adamcroft330/adamcroft.github.io/images/control-panel-testing.jpg

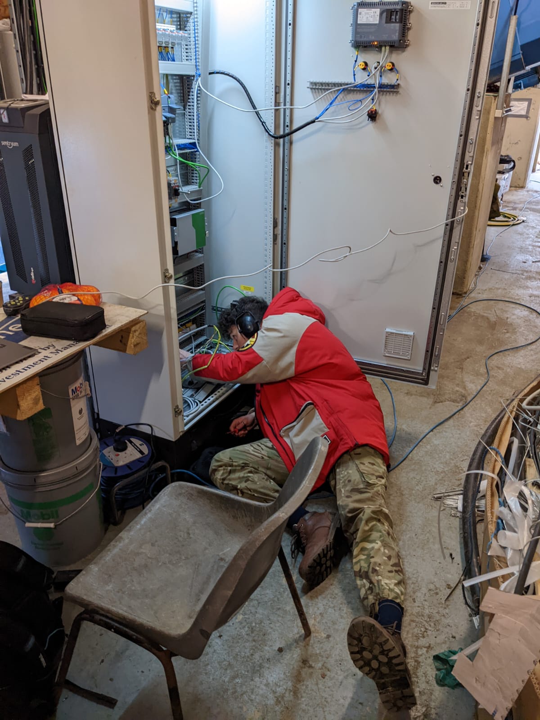
images/control-panel-testing.jpg
