adamcroft330/adamcroft.github.io/images/Settle-hydro-1.JPG

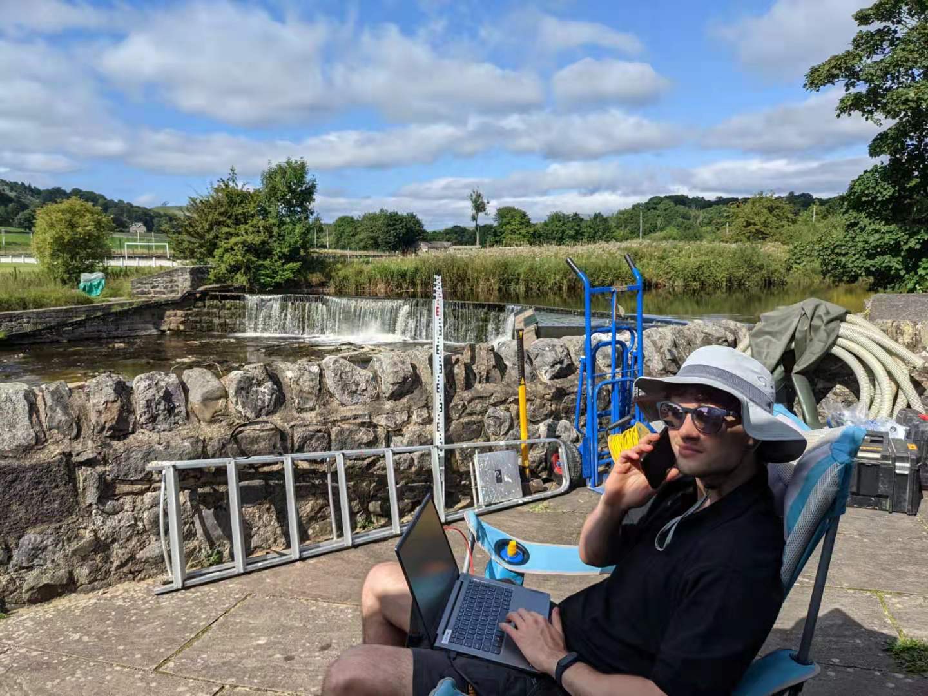
images/Settle-hydro-1.JPG
