adamcroft330/adamcroft.github.io/images/controlling_plane.jpg

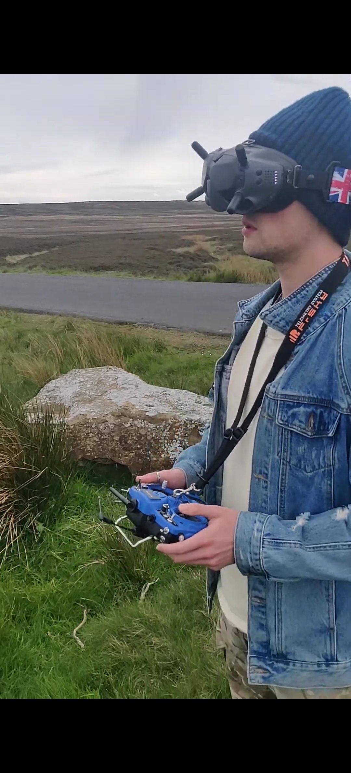
images/controlling_plane.jpg
