adamcroft330/adamcroft.github.io/images/evtol-bank-right.jpg

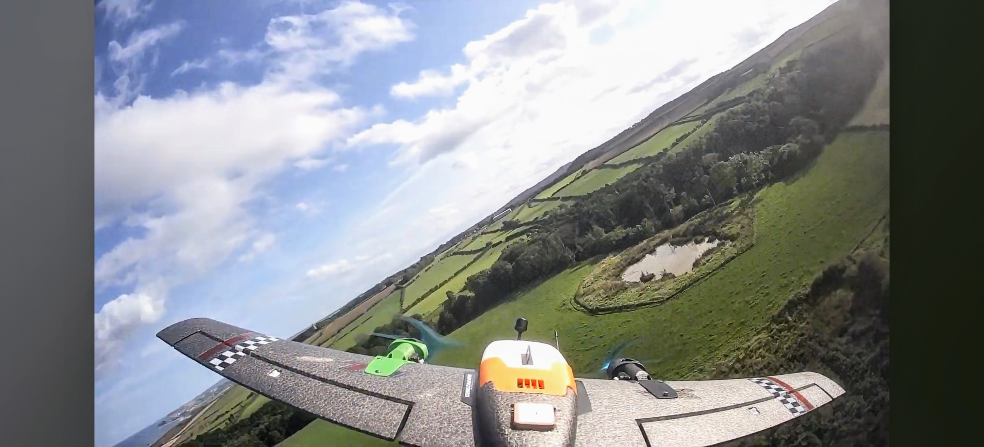
images/evtol-bank-right.jpg
