adamcroft330/adamcroft.github.io/images/evtol-on-wall.jpg

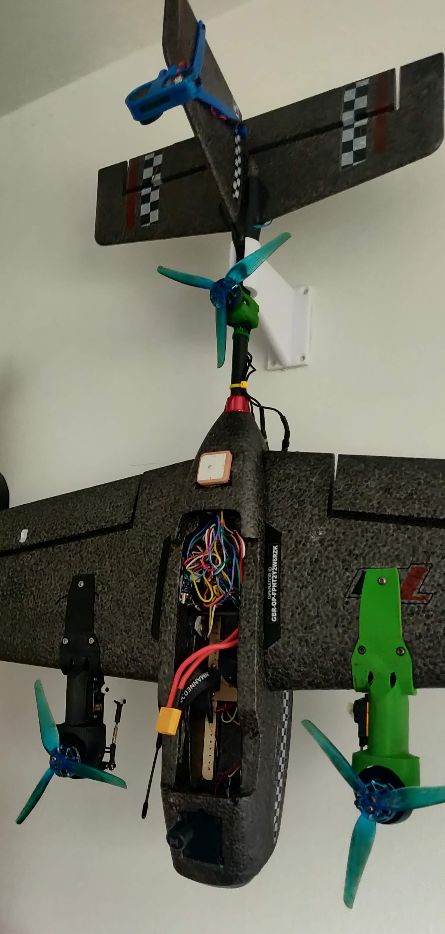
images/evtol-on-wall.jpg
