adamcroft330/adamcroft.github.io/images/nethermills-forebay.jpg

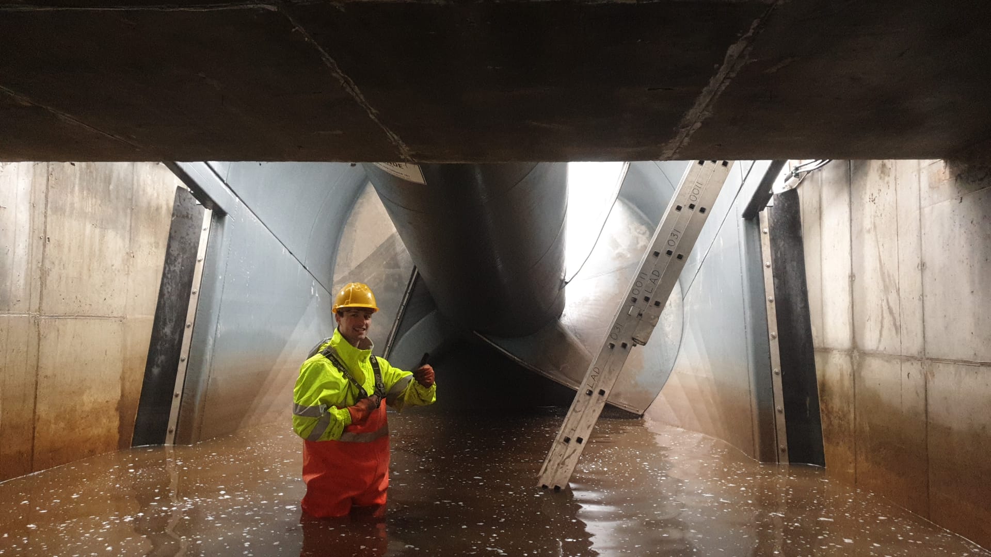
images/nethermills-forebay.jpg
