adamcroft330/adamcroft.github.io/images/p&a-goggles.jpg

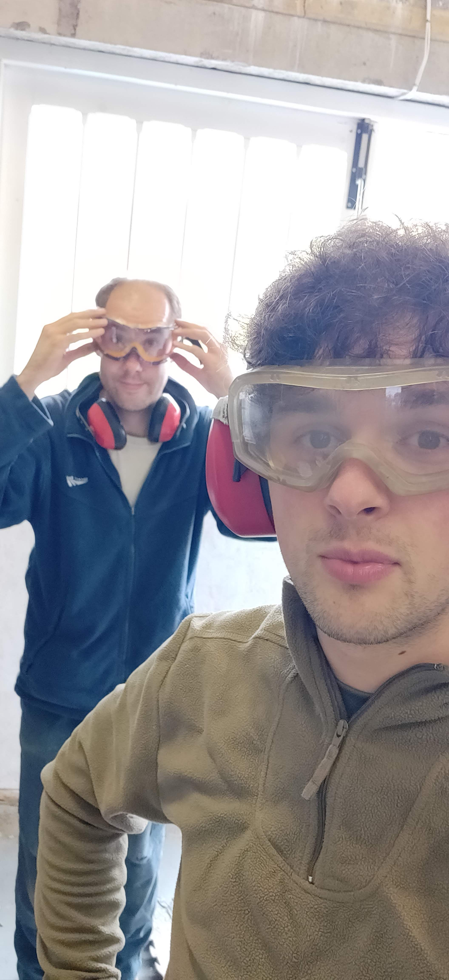
images/p&a-goggles.jpg
