adamcroft330/adamcroft.github.io/images/settle-boys.jpg

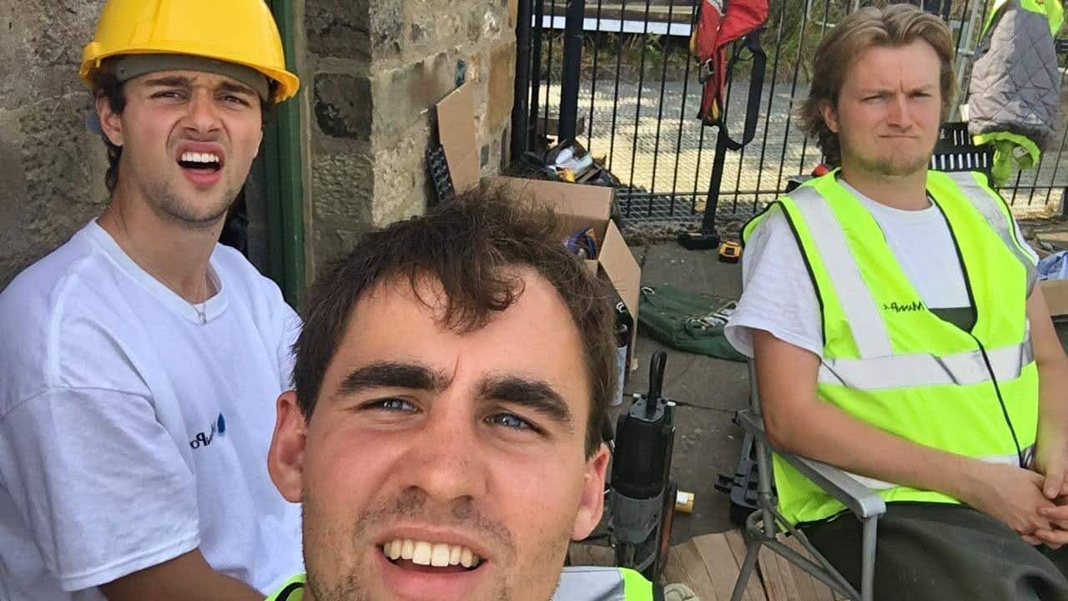
images/settle-boys.jpg
