adamcroft330/adamcroft.github.io/images/whats-that-noise.jpg

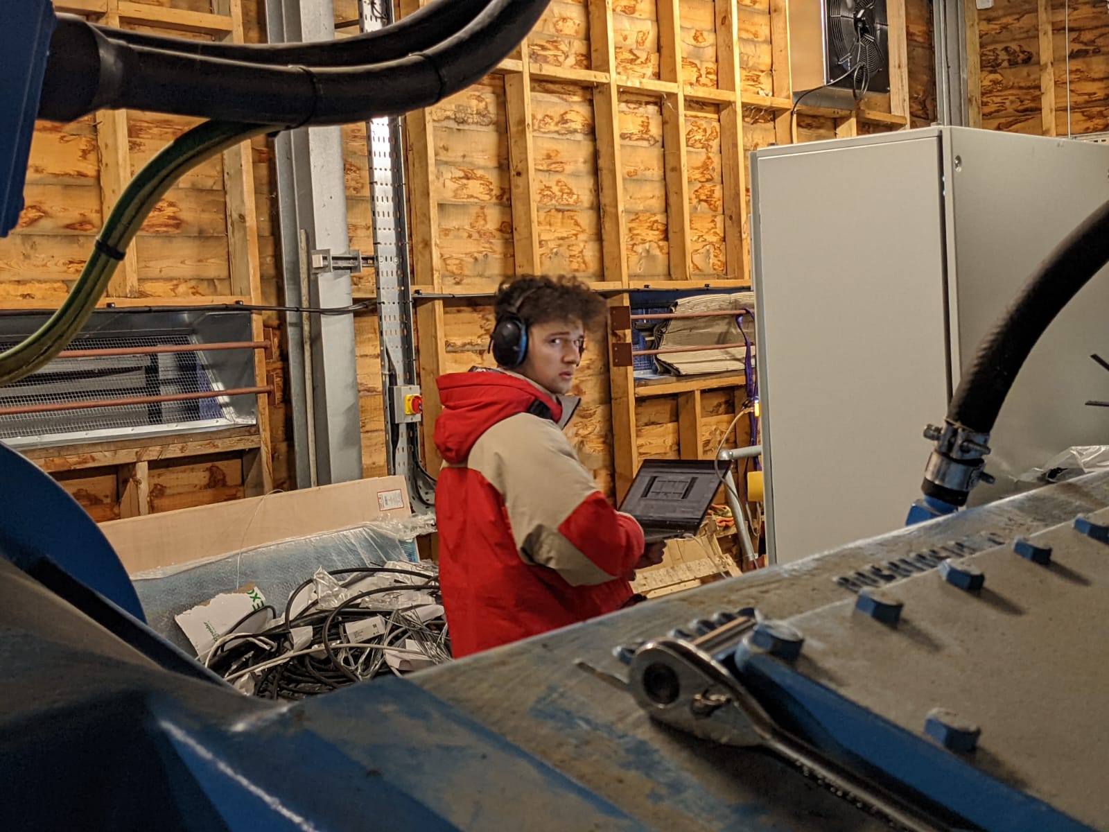
images/whats-that-noise.jpg
