adamcroft330/adamcroft.github.io/themis/cad/themis35-bom.csv

Group | Item | Part | Qty | Unit | Unit mass (g) | Line mass (g) | Mass source | Size | Size source | Material | Link | Notes
Airframe (printed) | Duct | Themis 35 duct, quadrant-trimmed bellmouth | 4 | each | 18.2 | 72.82 | cad | 106.7 × 106.7 × 31 mm | cad | SLS PA12, 1.2 mm wall; 2 dyed orange (front), 2 black | https://3dprint-uk.co.uk/3d-printing-services/ | One STL printed four times; front pair dyed orange
Airframe (printed) | Crest clip | Joins neighbouring ducts over the shared crest | 4 | each | 0.16 | 0.63 | cad | 27 × Ø2.7 mm | cad | SLS PA12 | https://3dprint-uk.co.uk/3d-printing-services/
Airframe (printed) | Spine | Cruciform pylon with harness conduit, ESC bosses and cable windows | 1 | each | 12.97 | 12.97 | cad | 41 × 41 × 42 mm | cad | SLS PA12 | https://3dprint-uk.co.uk/3d-printing-services/
Airframe (printed) | Camera fairing | Belly fairing for the downward camera, lens window | 1 | each | 4.9 | 4.9 | cad | 43 × 43 × 23.5 mm | cad | SLS PA12 | https://3dprint-uk.co.uk/3d-printing-services/
Airframe (printed) | Sensor blister | Fairing under motor 2's pad for the H-Flow | 1 | each | 1.89 | 1.89 | cad | 33 × 33 × 11.5 mm | cad | SLS PA12 | https://3dprint-uk.co.uk/3d-printing-services/
Airframe (printed) | Pod lower | Streamlined pod: floor, ledges, canopy posts, vents, spine slot | 1 | each | 36.8 | 36.8 | cad | 68 × 134 × 46 mm | cad | SLS PA12, 1.6 mm skin | https://3dprint-uk.co.uk/3d-printing-services/
Airframe (printed) | Canopy | Removable top shell with moulded front arrow | 1 | each | 22.54 | 22.54 | cad | 68 × 134 × 34 mm | cad | SLS PA12, 1.6 mm skin | https://3dprint-uk.co.uk/3d-printing-services/
Airframe (printed) | Pi shelf | 54 mm wide, keyed to its ledges | 1 | each | 7.58 | 7.58 | cad | 54 × 88 × 1.6 mm | cad | SLS PA12 | https://3dprint-uk.co.uk/3d-printing-services/
Airframe (printed) | Battery tray | 60 mm wide with front end stop and rear XT60 holder | 1 | each | 10.74 | 10.74 | cad | 60 × 102 × 8.1 mm | cad | SLS PA12 | https://3dprint-uk.co.uk/3d-printing-services/
Airframe (printed) | Nose bumper | Protects the Mightycam window; marks the front | 1 | each | 1.49 | 1.49 | cad | 35 × 4.5 × 39 mm | cad | TPU 95A, orange | https://3dprint-uk.co.uk/3d-printing-services/
Airframe (printed) | UWB hat | Low spine on the canopy roof: carries the UWB board above the battery | 1 | each | 4.51 | 4.51 | cad | 29 × 81 × 6 mm | cad | SLS PA12 | https://3dprint-uk.co.uk/3d-printing-services/ | Two M2.5 screws up through the roof; two cable ties hold the board
Airframe (printed) | Foot | TPU post with captive M2.5 nut; lowest point of the drone | 4 | each | 2.53 | 10.14 | cad | Ø10 × 29.5 mm | cad | TPU 95A, black | https://3dprint-uk.co.uk/3d-printing-services/
Airframe (carbon) | Carbon plate | Centre plate, arms, motor pads, tails; DXF exported | 1 | each | 24.44 | 24.44 | cad | 190 × 190 × 2.5 mm | cad | 3K carbon fibre, 2.5 mm | https://www.pcbway.com/rapid-prototyping/cnc-machining/plastic/carbon-fiber/carbon-fiber-plate/ | Quote also from Carbon Fibre Tubes Ltd (Fareham)
Propulsion | Motor | GEPRC SPEEDX2 2105.5 3450KV (3–4S), 12×12 M2, 1.5 mm shaft | 4 | each | 21.0 | 84.0 | retail | Ø25.65 × 15.7 mm; leads 22 AWG × 150 mm | retail | — | https://uk.banggood.com/en/GEPRC-SPEEDX2-2105_5-2650KV-or-3450KV-3-4S-Brushless-Motor-for-FPV-Racing-RC-Drone-p-1949985.html | Mass includes leads. Supplied with M2×6 and M2×7 screws. Use 3450KV: the 2150/2650KV versions are 6S motors
Propulsion | Propeller | Gemfan D90S 3-blade, 90 mm, 3" pitch, 1.5 mm T-mount | 4 | each | 2.3 | 9.2 | retail | Ø90 × 5.5 mm hub | retail | Polycarbonate | https://www.getfpv.com/gemfan-d90s-90mm-3-5-ducted-3-blade-cinewhoop-propeller-1-5mm-shaft-set-of-4.html | 2 CW + 2 CCW. Hub diameter modelled at 9 mm (not published)
Propulsion | 4-in-1 ESC | SpeedyBee BLS 35A Mini V2, 20×20, 3–6S, 35 A ×4 (45 A 5 s) | 1 | each | 7.2 | 7.2 | retail | 35 × 35 × 5.5 mm | retail | — | https://nextfpv.com/products/speedybee-bls-35a-mini-v2-20x20-4-in-1-esc | BLHeli_S, DShot300/600; current sensor scale 250, offset −500. Mounted rotated 45° between the ducts
Propulsion | ESC capacitor | 100 µF 35 V low-ESR electrolytic (Panasonic FR series), 4 fitted = 400 µF | 4 | each | 0.6 | 2.4 | est | Ø6.3 × 11.2 mm (est.) | est | — | https://uk.rs-online.com/web/c/?searchTerm=panasonic%20EEU-FR1V101 | A single Ø10 mm 470 µF (EEU-FR1V471, RS 708-3825) does not fit between the ducts; four small ones sit on the axes just outside the ESC
Power | Battery | GNB GNB11004S140A, 4S 1100 mAh 140C, XT60 | 1 | each | 141.0 | 141.0 | maker | 82 × 39 × 25 mm | maker | LiPo | https://www.gaoneng.shop/products/gaoneng-gnb-4s-14.8v-1100mah-140c-xt60-lipo-battery | Figures as cited in the AVA v2 README; the shop blocks automated reading, so check the listing
Power | Power module | Holybro PM02 V3, analog, 5.2 V 3 A to the Pixhawk | 1 | each | 20.0 | 20.0 | maker | 25 × 25 × 10 mm | retail | — | https://docs.px4.io/main/en/power_module/holybro_pm02 | Size from an OpenELab listing; Holybro does not publish it. XT60s removed, leads soldered. Its XT60/12 AWG are rated 30 A continuous, 60 A burst: cap PX4 thrust so total current stays under 60 A
Power | 5 V regulator | Pololu D36V50F5, 5 V 5.5 A, 5.5–50 V in | 1 | each | 7.0 | 7.0 | maker | 25.4 × 25.4 × 9.5 mm | maker | — | https://www.pololu.com/product/4091/specs | Feeds the Pi 5 through GPIO 5 V; set usb_max_current_enable=1
Power | XT60H-F | Amass XT60H female with housing | 2 | each | 3.6 | 7.2 | retail | 21.0 × 15.7 × 8.1 mm | retail | Nylon / brass | https://ifuturetech.org/product/amass-xt60h-female-connector-with-housing/ | Main socket (behind the battery) and arming socket (tail). Datasheet: cdn.eicom.ru/media/PDF/XT60H-M.pdf
Power | XT60H-M arming key | Amass XT60H male, pins bridged with 14 AWG, red pull tab | 1 | each | 4.5 | 4.5 | est | 21 × 15.7 × 8.1 mm + loop | retail | Nylon / brass / silicone | https://cdn.eicom.ru/media/PDF/XT60H-M.pdf | Pull it and the battery is disconnected: the accessible physical kill
Power | Battery strap | T-Hobby 15 × 200 mm battery strap | 1 | each | 2.5 | 2.5 | est | 15 × 200 mm | retail | Woven nylon | https://www.unmannedtechshop.co.uk/products/t-hobby-battery-straps-15x200mm-new
Flight control | Flight controller | Holybro Pixhawk 6C Mini (Model A), PX4 | 1 | each | 39.2 | 39.2 | maker | 54.3 × 39 × 17.5 mm | maker | Aluminium case | https://docs.holybro.com/autopilot/pixhawk-6c-mini/dimensions | Mass from PX4 docs. Motors on the FMU outputs (DShot). Cable set supplied: 6-pin GH ×5, 4-pin GH ×3, PWM ×2
Flight control | Mounting foam | 3M 4026 urethane foam tape, 1.6 mm (4 pads) | 1 | each | 0.5 | 0.5 | est | 1.6 mm thick | maker | Urethane foam | https://hoffmann-group.com/GB/en/houk/p/7000116032- | Under the Pixhawk, PM02 and BEC
Flight control | ELRS receiver | RadioMaster RP1 V2, 65 mm UFL T-antenna | 1 | each | 2.2 | 2.2 | retail | 13 × 11 × 3 mm | retail | — | https://www.getfpv.com/radiomaster-rp1-v2-expresslrs-2-4ghz-nano-receiver-w-65mm-ufl-t-antenna.html | CRSF to Pixhawk TELEM1; kill switch only. Mass includes antenna
Companion compute | Raspberry Pi 5 | Raspberry Pi 5, 2 GB | 1 | each | 46.0 | 46.0 | retail | 85 × 56 mm PCB; M2.5 holes on 58 × 49 | maker | — | https://datasheets.raspberrypi.com/rpi5/raspberry-pi-5-mechanical-drawing.pdf | Mass from retailer listings (45–46 g). Port heights from the Pi 4 equivalents
Companion compute | Active Cooler | Raspberry Pi Active Cooler for Pi 5 | 1 | each | 29.0 | 29.0 | retail | 63.5 × 42.5 × 13.7 mm | maker | Anodised aluminium | https://datasheets.raspberrypi.com/cooling/raspberry-pi-active-cooler-product-brief.pdf
Companion compute | microSD | High-endurance microSD, 32 GB | 1 | each | 0.4 | 0.4 | est | 15 × 11 × 1 mm | maker | — | https://uk.rs-online.com/web/c/?searchTerm=sandisk%20high%20endurance%20microsd%2032gb | Read-only root filesystem: the arming plug cuts power instantly
Sensors | Downward camera | Arducam B0445, IMX296 colour global shutter, M12 mount | 1 | each | 14.0 | 14.0 | est | 38 × 38 mm board; 13 mm holder | retail | — | https://www.arducam.com/1-58mp-imx296-color-global-shutter-camera-module-with-m12-lens-for-raspberry-pi.html | 14 g is the mono twin's listed weight with its stock lens. Hole pattern to confirm on delivery
Sensors | Camera fixings | M2 × 8 nylon screw + 2 mm nylon spacer, ×4 (hole pattern to confirm) | 4 | each | 0.15 | 0.6 | est | Ø4 × 2 mm spacer | est | Nylon | https://uk.rs-online.com/web/c/?searchTerm=M2%20nylon%20spacer%202mm
Sensors | Wide lens | Arducam M27210H08 (LN005), 2.1 mm M12, 120° HFOV on 1/2.9" | 1 | each | 5.0 | 5.0 | est | Ø14 × 16 mm (est.) | est | — | https://www.arducam.com/blog/product/m27210h08-2/ | Buy one first and check focus in the B0445 holder
Sensors | Camera ribbon | 22-pin 0.5 mm FPC, 200 mm (supplied 22-22 with the B0445; check length) | 1 | each | 1.0 | 1.0 | est | 200 × 13 × 0.3 mm (est.) | est | Polyimide | https://www.arducam.com/1-58mp-imx296-color-global-shutter-camera-module-with-m12-lens-for-raspberry-pi.html
Sensors | Optical flow + range | Holybro H-Flow (bare PCB), PAA3905 + AFBR-S50 + IMU, DroneCAN | 1 | each | 3.5 | 3.5 | retail | 26 × 26 mm PCB; 20×20 M2 holes | maker | — | https://docs.holybro.com/peripherals/h-flow-dronecan/dimensions | Component height modelled at 4 mm (from the case drawing). CAN cable supplied
Sensors | Forward camera | Mighty Camera V.1: 160°, VIO 60 Hz, USB 2.0 | 1 | each | 10.0 | 10.0 | maker | 33 × 30 mm PCB | maker | — | https://mightycamera.com | Lens size modelled at Ø12 × 9 mm (not published)
Comms | UWB board | Makerfabs ESP32 UWB DW3000: ESP32 + Qorvo DW3000, USB to the Pi | 1 | each | 12.0 | 12.0 | est | 72.0 × 32.6 mm board (Makerfabs board file); 6.3 mm deep | maker | FR4 | https://www.tindie.com/products/makingfab/esp32-uwb-dw3000/ | Rides on the canopy hat, above every drone's body; no carrier PCB to design. Check the DW3000 antenna's orientation on the bench
Comms | Mightycam USB lead | USB 2.0 lead, right-angle USB-A, about 150 mm | 1 | each | 6.0 | 6.0 | est | Ø3.2 mm cable | est | — | https://uk.rs-online.com/web/c/?searchTerm=right%20angle%20usb%20a%20cable%20150mm | Mightycam-side connector to confirm
Comms | UWB USB lead | Micro-USB to right-angle USB-A, about 250 mm, down through the canopy roof | 1 | each | 7.0 | 7.0 | est | Ø3.2 mm cable | est | — | https://uk.rs-online.com/web/c/?searchTerm=right%20angle%20usb%20a%20to%20micro%20usb%20cable | Unplug at the board to lift the canopy off
Wiring | 14 AWG silicone wire | Red + black, battery to PM02 to ESC | 0.447 | m | 28.2 | 12.61 | retail | Ø3.5 mm; 28.2 g/m per core | retail | Copper / silicone | https://shop.pimoroni.com/en-eu/products/dual-silicone-wire-per-metre
Wiring | 20 AWG silicone wire | Red + black, PM02 to BEC to Pi | 0.212 | m | 7.1 | 1.51 | retail | Ø1.8 mm; 7.1 g/m per core | retail | Copper / silicone | https://shop.pimoroni.com/en-eu/products/dual-silicone-wire-per-metre
Wiring | JST-GH signal leads | TELEM1, TELEM2, POWER, CAN1 (from the Pixhawk/PM02/H-Flow sets, re-pinned) | 0.594 | m | 15.0 | 8.91 | est | Ø2.0–2.6 mm bundles; 15 g/m est. | est | Copper / PVC | https://www.worldronemarket.com/product/holybro-pixhawk-6c-mini-cable-set/
Wiring | ESC signal lead | JST-SH 8-pin to Pixhawk PWM header (supplied with ESC) | 0.072 | m | 15.0 | 1.08 | est | Ø2.8 mm bundle; 15 g/m est. | est | Copper / PVC | https://nextfpv.com/products/speedybee-bls-35a-mini-v2-20x20-4-in-1-esc
Wiring | Heat-shrink and cable ties | Assorted, 1.5–6 mm | 1 | each | 2.0 | 2.0 | est | — | — | Polyolefin / nylon | https://uk.rs-online.com/web/c/?searchTerm=heat%20shrink%20assortment
Fasteners & inserts | M2 × 6 cap screw | Motor mount (supplied with the motors) | 16 | each | 0.33 | 5.25 | cad | M2 × 6, head Ø3.8 × 2 | maker | Steel | https://uk.banggood.com/en/GEPRC-SPEEDX2-2105_5-2650KV-or-3450KV-3-4S-Brushless-Motor-for-FPV-Racing-RC-Drone-p-1949985.html
Fasteners & inserts | M3 × 16 button head | ESC stack: plate, grommets, ESC, spine inserts (ISO 7380 A2) | 4 | each | 1.23 | 4.9 | cad | M3 × 16, head Ø5.7 × 1.65 | maker | A2 stainless | https://accu-components.com/us/button-head-screws
Fasteners & inserts | M2.5 × 12 cap screw | Duct boss, plate, foot nut (DIN 912 A2) | 4 | each | 0.78 | 3.12 | cad | M2.5 × 12, head Ø4.5 × 2.5 | maker | A2 stainless | https://accu-components.com/us/metric-cap-head-screws/3807-SSCF-M2-5-12-A2
Fasteners & inserts | M2.5 nut | Captive in each foot (DIN 934 A2) | 4 | each | 0.34 | 1.37 | cad | 5 AF × 2 mm | maker | A2 stainless | https://accu-components.com/us/hexagon-nuts
Fasteners & inserts | M2.5 × 6 button head | Pod floor to spine cap, under the Pixhawk foam (ISO 7380 A2) | 4 | each | 0.42 | 1.7 | cad | M2.5 × 6, head Ø4.7 × 1.4 | maker | A2 stainless | https://accu-components.com/us/button-head-screws
Fasteners & inserts | M2.5 × 6 cap screw | Pi shelf and battery tray to their ledges; UWB hat through the canopy roof (DIN 912 A2) | 6 | each | 0.55 | 3.28 | cad | M2.5 × 6, head Ø4.5 × 2.5 | maker | A2 stainless | https://accu-components.com/us/metric-cap-head-screws
Fasteners & inserts | M2 × 10 cap screw | H-Flow through motor 2's pad (DIN 912 A2) | 4 | each | 0.43 | 1.71 | cad | M2 × 10, head Ø3.8 × 2 | maker | A2 stainless | https://accu-components.com/us/metric-cap-head-screws
Fasteners & inserts | M2 nut | Under the H-Flow (DIN 934 A2) | 4 | each | 0.18 | 0.7 | cad | 4 AF × 1.6 mm | maker | A2 stainless | https://accu-components.com/us/hexagon-nuts
Fasteners & inserts | M2 × 4 spacer | Holds the H-Flow below the motor screw heads (nylon) | 4 | each | 0.04 | 0.17 | cad | Ø4 × 4 mm | est | Nylon | https://uk.rs-online.com/web/c/?searchTerm=M2%20nylon%20spacer%204mm
Fasteners & inserts | M2.5 × 3 standoff | Pi 5 to shelf, F-F (nylon) | 4 | each | 0.07 | 0.3 | cad | 5 AF × 3 mm | est | Nylon | https://uk.rs-online.com/web/c/?searchTerm=M2.5%20female%20female%20standoff%203mm
Fasteners & inserts | M2.5 × 6 nylon screw | Pi 5 to standoffs, standoffs to shelf | 8 | each | 0.08 | 0.63 | cad | M2.5 × 6, head Ø4.5 × 2.5 | est | Nylon | https://uk.rs-online.com/web/c/?searchTerm=M2.5%20nylon%20screw%206mm
Fasteners & inserts | M3 thumb screw | Canopy, into the four posts (nylon, knurled) | 4 | each | 0.29 | 1.17 | cad | M3 × 8, head Ø8 × 4 | est | Nylon | https://uk.rs-online.com/web/c/?searchTerm=M3%20nylon%20thumb%20screw
Fasteners & inserts | M3 heat-set insert | CNC Kitchen M3 standard: spine ESC bosses, canopy posts | 8 | each | 0.4 | 3.2 | est | 4.6 × 5.7 mm; 4.0 mm hole | retail | Brass | https://www.3djake.com/cnc-kitchen/threaded-inserts-m3-standard
Fasteners & inserts | M2.5 heat-set insert | CNC Kitchen M2.5: spine cap, shelf and tray ledges, UWB hat | 10 | each | 0.3 | 3.0 | est | 4.6 × 4.0 mm; 4.0 mm hole | retail | Brass | https://www.3djake.com/cnc-kitchen/threaded-inserts-m25-standard
Fasteners & inserts | M3 aluminium spacer | Hard-mounts the ESC stack: 1 mm under the ESC, 4.4 mm over it (4 mm spacer + 0.4 mm shim) | 8 | each | 0.15 | 1.18 | cad | Ø6 × 1 mm and Ø6 × 4.4 mm, M3 clearance | est | Aluminium | https://accu-components.com/us/spacers/aluminium-spacers | Replaces the ESC's silicone grommets: on those the pod and battery would rock at an estimated 10–20 Hz
Finishing | Decal set | Motor numbers, rotation arrows (PX4 Quad X), FRONT arrow | 1 | each | 0.3 | 0.3 | est | — | — | Vinyl | CAD/themis35/build_t35.py | Artwork follows the rotation marks in the CAD
 | All up, every line |  |  |  |  | 730.9
