adamcroft330/adamcroft.github.io/themis/track/models/course_1337_tape.stl

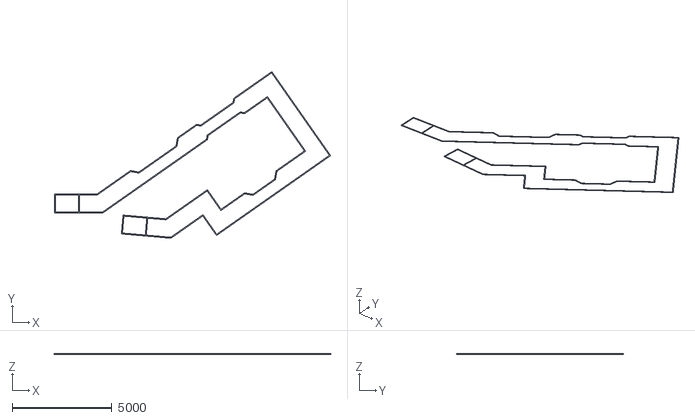
[picture p10: CAD file, 2026-09-12]
themis/track/models/course_1337_tape.stl
13854.9 x 8357.4 x 2.00
