adamcroft330/adamcroft.github.io/themis/track/models/course_1337_hurdles.stl

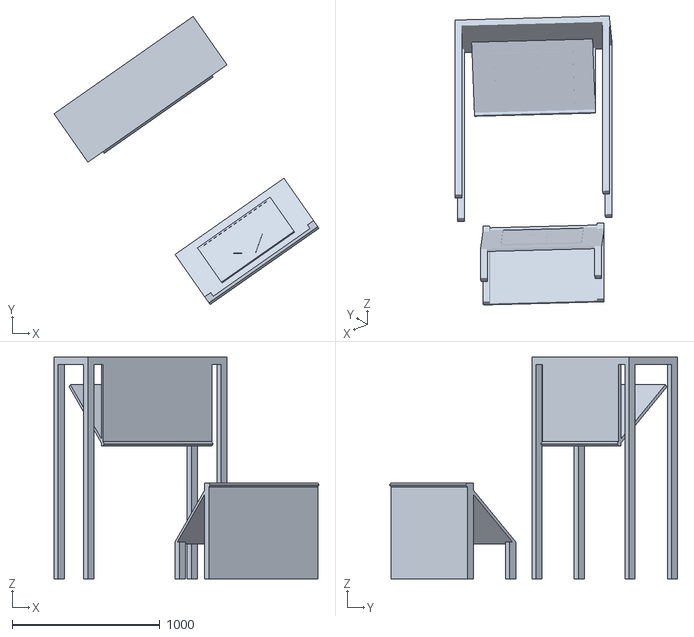
[picture p11: CAD file, 2026-09-12]
themis/track/models/course_1337_hurdles.stl
1794.1 x 1951.1 x 1500.0
