adamcroft330/adamcroft.github.io/themis/track/models/course_1337.stl

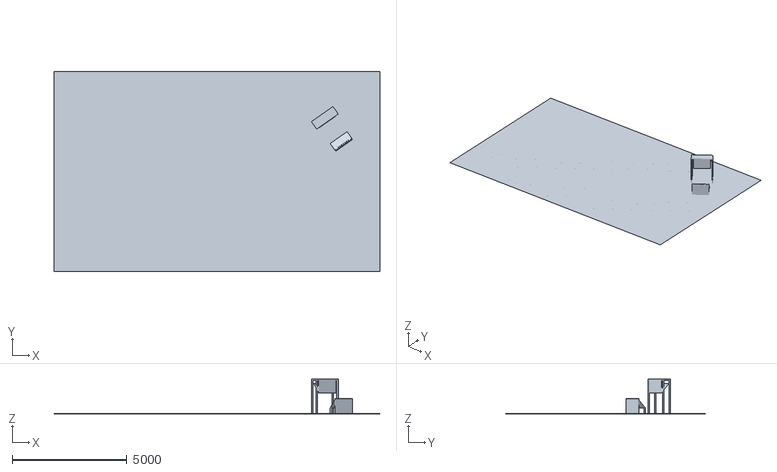
[picture p12: CAD file, 2026-09-12]
themis/track/models/course_1337.stl
14204.9 x 8707.4 x 1510.0
