adamcroft330/adamcroft.github.io/(commit log)

2024-11-16 Added photos page with 1 photo. Updated index and evtol pages with navigation button to photos page.
2025-03-16 added robotic-arm page”
2026-08-07 Update swarm sim: fix FPV track tiles vanishing while panning
2026-08-10 Add decision feed, why-line and velocity term arrows
2026-08-10 Velocity arrows: default off with per-term toggles
2026-08-10 10m ground history + centroid velocity arrow
2026-08-10 Centroid velocity shows detour lateral component
2026-08-10 Add 味 menu site at /menu
2026-08-10 Auto-classify dishes on upload; remove AI Classify button
2026-08-11 Mobile cuisine filter (select), hide empty cuisines, clear stale cache
2026-08-12 Themis drone build: interactive 3D viewer with STL models + part breakdown
    [assembly.stl, battery.stl, cm5.stl, esc.stl, fitment_check.stl, frame.stl, guard.stl, hailo.stl]
2026-08-12 Rename drone-build → themis
    [assembly.stl, battery.stl, cm5.stl, esc.stl, fitment_check.stl, frame.stl, guard.stl, hailo.stl]
2026-08-12 Fix 3D viewer: use script tag instead of importmap, add inline STL loader
2026-08-12 v3 drone model: realistic frame, shaped arms, detailed components
    [assembly_v3.stl, battery_v3.stl, cam_v3.stl, cm5_v3.stl, esc_v3.stl, frame_v3.stl, guard_v3.stl, hailo_v3.stl]
2026-08-12 Fix: all 4 motors/props at correct positions, update viewer center, clean up models
    [assembly_v3.stl, battery.stl, battery_v3.stl, cam.stl, cam_v3.stl, cm5.stl, cm5_v3.stl, esc.stl]
2026-08-13 Custom 3D-printed frame plate: 195mm true-X, 120x70mm center body, 16mm motor mounts, 1806 motors, TWR 3.25:1
    [assembly.stl, battery.stl, cam.stl, cm5.stl, esc.stl, frame.stl, guard.stl, hailo.stl]
2026-08-13 Fix: remove geometry centering that was collapsing Z positions — props now clear frame, hardware sits on plate
2026-08-13 Brighter lighting (4x dir light, 2x ambient), add 50mm scale ruler along X axis
2026-08-13 Screen-anchored scale ruler: projects 250mm bbox to screen px, ticks every 12.5mm, labels every 50mm
2026-08-13 Fix 250mm fit: remove prop guard mounting stubs (was 133.5mm, now 124mm), ring centered on prop disc, envelope 248mm PASSES
    [assembly.stl, guard.stl, motor.stl, plate.stl, prop.stl]
2026-08-13 Switch to orthographic camera: uniform scale on screen, ruler exact from every angle, add resize handling
2026-08-13 Restore perspective camera with static CSS scale ruler — ortho had unreproducible rendering bug in headless Chrome
2026-08-13 Replace static CSS ruler with 3D in-scene ruler at bounding box front face — scales correctly with zoom and perspective
2026-09-08 Add SparkLab learning-lab prototype at /lab
2026-09-10 Pi 5 build v4: real official Pi 5 model (STEP-converted), proper Z-stacking (ESC flat, FC on standoffs, Pi5 beside), downward ToF under plate, Y-up scene fix, updated BOM ()
    [assembly.stl, cam.stl, cm5.stl, esc.stl, guard.stl, motor.stl, pi5.stl, pi5_real.stl]
2026-09-12 Themis hub page: landing at /themis/ linking to racing sim (/swarm/), CAD viewer (/themis/cad/), and track model (/themis/track/); fix root card link from stale /drone-build/
    [assembly.stl, cam.stl, esc.stl, guard.stl, motor.stl, pi5.stl, pi5_real.stl, pixhawk.stl]
2026-09-12 Themis track page: real competition course per brief addendum + seeded 3D course generator
    Replaces the placeholder 1:10 sim-derived spec with the addendum spec (900 mm
    tape corridor, bends, 90° turns, 900→600 mm narrowings, overhead hurdle),
    an in-browser Three.js viewer that regenerates courses by seed, and the
    OpenSCAD-rendered STLs for seed 1337.
    Claude-Session: https://claude.ai/code/session_013weHv1XZhrGrUYx5aVWETm
    [course_1337.stl, course_1337_hurdles.stl, course_1337_tape.stl]
2026-09-12 Line Follower starts with an empty program — kids build it from scratch
2026-09-14 Themis CAD: Integrated housing on Dingcad frame — replace quad viewer with 106-part colored model, explode + internals controls
2026-09-14 Themis RL Eval: live PufferLib training env in the browser (raylib/WebAssembly) at /themis/RL_eval/
    Four drones on random addendum courses with the classical tape-frame planner
    and the bounded RL residual, PX4-style cascade and rotor physics, rendered
    with raylib compiled by Emscripten. Untrained build = classical baseline; a
    trained checkpoint is packed by training/web/publish.sh. Hub card added.
    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
2026-09-14 Themis CAD: slim housing to 92mm, remove Pi5 USB-A/Ethernet bank — drop obsolete quad STLs
    [assembly.stl, cam.stl, esc.stl, guard.stl, motor.stl, pi5.stl, pi5_real.stl, pixhawk.stl]
2026-09-14 RL Eval: rebuild with the formation manager (named slots, resizable box, single-file deviation)
    Baseline over 48 episodes: score -29.3 -> -20.5, tape contacts 14.3 -> 8.7,
    hurdle 0.5 -> 0.1, formation error 0.34 -> 0.21 m, still 100% finish.
    HUD now names the formation shape and the selected drone's slot.
    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
2026-09-14 RL Eval: rebuild with the margin-balanced box and in-box formation grading
    Baseline over 48 episodes: score -20.5 -> -19.4, tape contacts 8.7 -> 8.3,
    formation error 0.214 -> 0.190 m, lap 28.3 -> 25.7 s, still 100% finish.
    Box spacing is now 383 mm, the width that balances tape margin against
    drone-to-drone gap in a 900 mm corridor.
    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
2026-09-14 RL Eval: fix tape drawn across the track at corners; show centroid and slot offsets
    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
2026-09-15 themis/RL_eval: publish the v9 residual policy
    First policy to beat the classical baseline on held-out courses:
    score -15.58 vs -20.12, finish rate 1.00, race time 27.2 s.
    Rebuilt the wasm as well as the weights: the env now bounds the residual with
    tanh rather than clamping it, and v9 was trained under that bound, so the
    previous bundle would have run the policy through the wrong nonlinearity.
    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
2026-09-15 themis/RL_eval: publish v10, trained on the dynamic-slot baseline
    Held-out score -14.25 (v9 was -15.58, classical baseline -20.12), finish 1.00.
    The swarm now lets slot labels rotate with the tape frame through a turn instead
    of making each drone orbit the centroid to keep its label, which is worth 2.5
    points on its own and reduces worst reform time from 3.84 s toward the 2 s rule.
    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
2026-09-15 themis/RL_eval: publish v11, formation now pivots at corners
    Held-out score -13.45 (v10 -14.25, classical baseline -20.12), finish 1.00.
    The slot relabel is now anticipatory: slot offsets are rotated by the heading
    change ahead before asking who is closest, so at a 90 deg right turn the two
    right-hand drones become the two front drones instead of every drone orbiting
    the centroid to keep its label. Corner slot error drops to -0.041 / -0.007 m
    from -0.127 / +0.128.
    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
2026-09-15 themis/RL_eval: rebuild on the current env (policy unchanged, v12)
    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
2026-09-19 Themis CAD: publish aligned AVA v2 frame comparison
2026-09-20 Refine AVA comparison geometry and remove camera drag lag
2026-09-24 Correct v2 payload frame supports and fastener stack
2026-09-27 Add TerraHawk v1 crash summary page at /terrahawk_crash
    One-page occurrence summary of the 27 Sep 2026 QuickTune hover crash:
    the sequence of events, why the tune-induced oscillation caused the
    motor-mount failure (not the reverse), contributing factors, open
    questions and actions before the next flight. It includes the
    "which came first" chart and links to the full report at a fixed
    adSwarm commit.
    Claude-Session: https://claude.ai/code/session_01TvNkatcBVSaqPkaLqg5MZF
2026-10-28 themis/cad: publish Themis 35 r2, keep the AVA comparison as history
    The CAD page now shows the Themis 35 build: the 3D bench with an exploded
    view and a centre-of-mass marker beside the full 58-line BOM, the geometry
    checks, the BOM as CSV and a zip of the STEP, print STLs and plate DXF.
    The original/AVA v2 comparison moves to history.html, linked from the new
    page; the build guide, the Themis index card, the track page and the 404
    now point at the right place.
2026-10-28 themis/cad: add the CineLog35 V2 build beside Themis 35 r3
    The CAD page now carries two frames for the same stack, with a switch,
    each frame's own model, BOM, checks, limits and downloads, and a
    side-by-side comparison.
    Custom frame r3: the ESC stack is hard-mounted on aluminium spacers
    (on silicone grommets the pod and battery would rock at an estimated
    10-20 Hz), and the UWB moves to a Makerfabs ESP32 UWB DW3000 board on a
    low hat on the canopy roof, clear of every body; motor 1 loses its
    blister.
    CineLog35 V2 draft: GEPRC's frame modelled from its published figures
    and photos, with the stock inverted motors, a short pylon that keeps
    the pod 22 mm above the guard, an H-Flow bridge across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
2026-10-28 themis/track: sync course_gen.js comments with the themis repo
    The generator moved from CAD/track to course/ in the themis repo. Only
    comments and toScad's default include path change; this page never calls
    toScad, so the courses it generates are unchanged.
    Claude-Session: https://claude.ai/code/session_01JBhNSSbWJuEgwtzLbCs1v7
2026-10-29 themis/RL_eval: new env (Themis 35 sizes and airframe), classical baseline
    For review: the env now models the drones at their CAD size (213 mm across,
    730 g, 142 mm wheelbase) instead of 250 mm cubes at 430 g, and the page flies
    the classical planner with no RL residual. Policy v12 was trained on the old
    env, so it is not packed. Built from themis 7b655b5 plus uncommitted env
    changes; the renderer and legend show the new drone size.
    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
2026-10-29 themis/RL_eval: lanes + UWB chain controller on T, sharper canvas
    Press T to switch between the September controller (centroid and slots) and
    the proposed one: no centroid, each drone holds its lane from the tape and its
    spacing by one UWB range in a chain behind the front-right drone, which sets
    the speed; a compact box slides through 90-degree turns. The new controller's
    view draws the leader, what it reads ahead, the chain links coloured by
    spacing error and where each follower is aiming. The canvas now matches the
    screen's real pixels, so the full-screen view is sharp on high-density screens.
    Claude-Session: https://claude.ai/code/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
2026-10-29 themis/RL_eval: the T controller now holds slots to the leader
    The alternative controller on T no longer runs a chain of followers, which was
    too slow for a feature every ~2 m. Each drone holds its lane from the tape and
    its slot relative to the front-right drone, which sets the speed and
    broadcasts it with its progress; shape changes run on the leader's schedule,
    and a compact box slides through 90-degree turns. Progress is estimated by
    odometry realigned at every feature and trimmed by UWB ranges. The view draws
    a link from each follower to the leader and the slot it is aiming for.
    Claude-Session: https://claude.ai/code/session_01JBh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
2026-10-29 themis/RL_eval: drones with their payload; like-for-like controllers
    The drones are drawn from the CAD with their ducts, pod, canopy and UWB hat
    instead of a flat frame. Both controllers now run on realistic sensing
    (odometry with feature fixes, UWB ranges), so the T switch compares like with
    like, and the 90-degree slide is off until it pays. Tape contacts count only
    once more than half a drone is over the line.
    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
2026-10-29 themis/RL_eval: camera model and no map
    Both controllers now also fly on a downward camera's lateral reports and see
    only 1.5 m past the front drone, as they would without a map.
    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
2026-10-30 themis/RL_eval: leader controller fixes, slower bends (themis bd6fa34)
    Classical baseline, no policy. Both controllers fly with a per-drone speed cap and
    slower bends (v_bend45 0.9, v_turn90 0.65); the leader controller merges into single
    file on measured clearances, holds each drone to the one ahead, and parks per slot.
    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
2026-10-30 themis/RL_eval: forward camera view; leader controller merges in line order (themis 8eeb170)
    Classical baseline, no policy. Top right: the selected drone's forward camera with what
    the sim's perception takes from it (V toggles, 1-4 pick the drone). The leader controller
    now merges into single file in line order and no longer deadlocks at a taper.
    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
2026-10-30 themis/RL_eval: forward camera tilted 20 degrees; realistic sensing with 3 m sight; mixed courses (themis b107d9f)
    Classical baseline, no policy. The forward camera view is tilted 20 degrees nose-down,
    the env runs the contract-4 defaults (leader controller, UWB, camera model, 3 m of
    sight for the forward camera), and the 60 page courses use the mixed obstacle spacing.
    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
2026-10-30 themis/RL_eval: forward camera detection model (themis 5a68c02)
    Classical baseline, no policy. Past the downward camera's 1.5 m, features come from a
    modelled forward detector: sight drawn per run between 2 and 3.5 m, features placed about
    10 cm off, turn angles about 3 degrees off, some missed. The camera view shows each
    run's sight.
    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
2026-10-30 themis/cad: tilt the Mightycam 20 degrees down; refresh r3 checks
